Edsol/esphome-ideal-clima-nemo/board_images/1.jpg

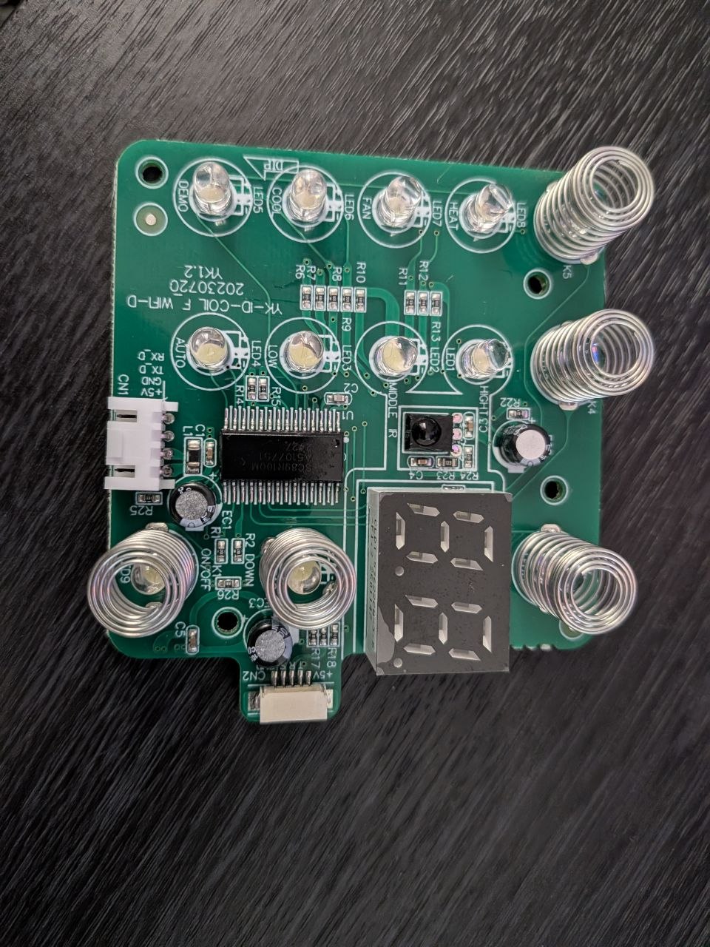
board_images/1.jpg
