Edsol/esphome-ideal-clima-nemo/board_images/2.jpg

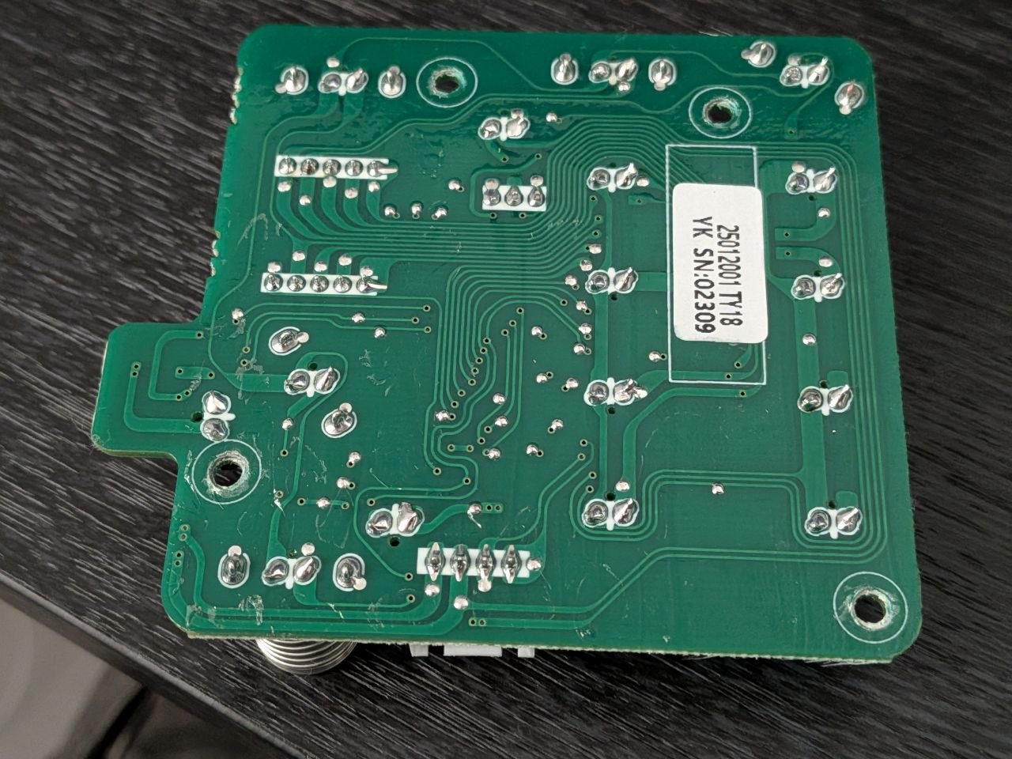
board_images/2.jpg
