Edsol/esphome-ideal-clima-nemo/board_images/3.jpg

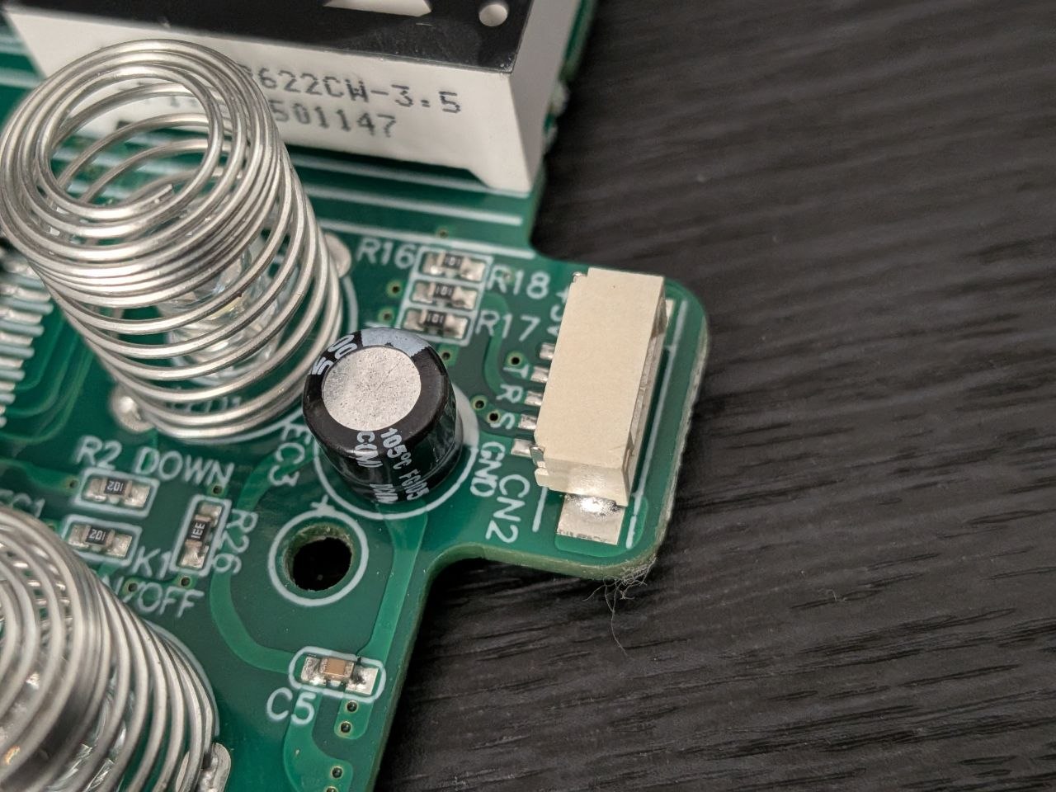
board_images/3.jpg
