Edsol/esphome-ideal-clima-nemo/board_images/4.jpg

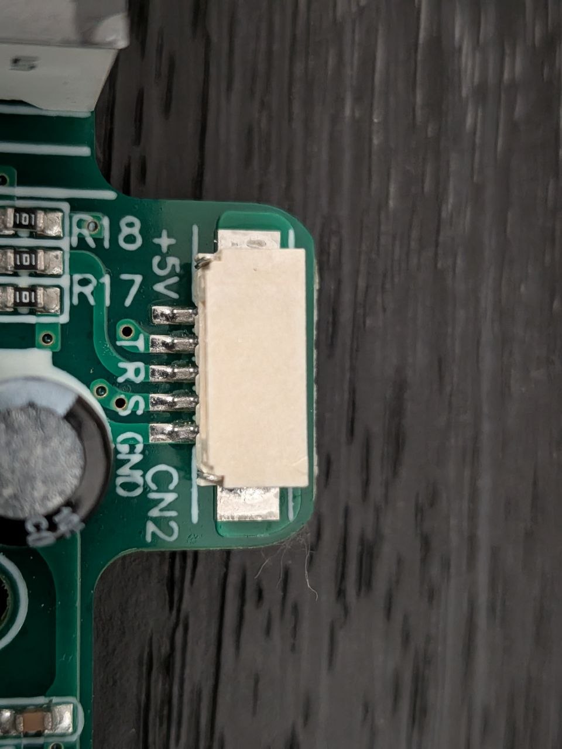
board_images/4.jpg
