Edsol/esphome-ideal-clima-nemo/board_images/5.jpg

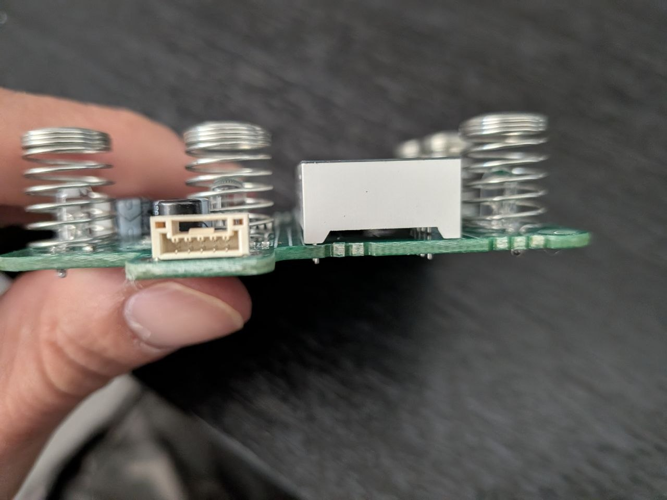
board_images/5.jpg
