Edsol/esphome-ideal-clima-nemo/board_images/6.jpg

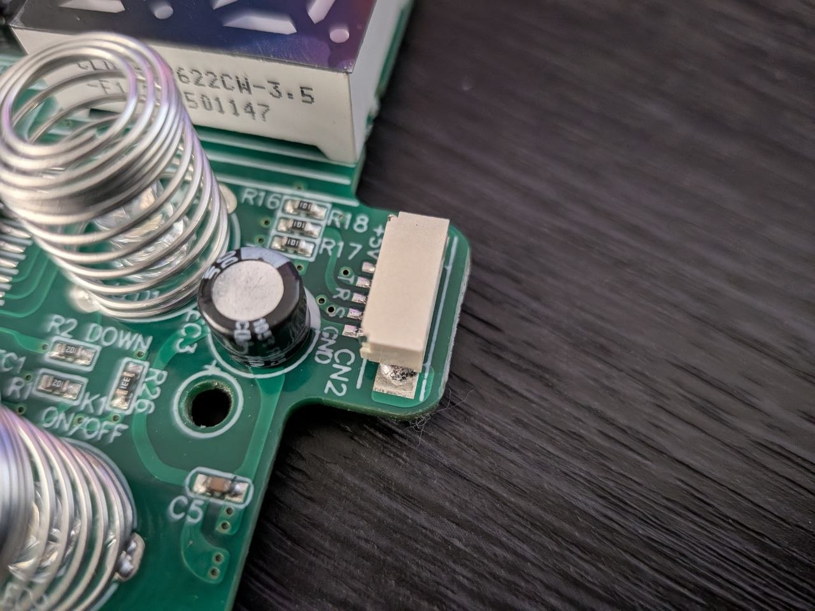
board_images/6.jpg
