Edsol/esphome-ideal-clima-nemo/(commit log)

2026-06-20 Initial public release: Ideal Clima Nemo 1000 local control (ESP32-C3)
    Reverse-engineered Tuya MCU integration over the CN2 connector, with two
    Home Assistant integrations sharing a common core library:
    - esp32/ IdealClimaTuya core library + Arduino example + wiring guide
    - esphome/ native ESPHome climate component
    - mqtt/ PlatformIO firmware with MQTT + HA discovery
    - extra/ PC tools (passive sniffer + terminal controller)
    All docs/comments in English. Direct 3.3V wiring on CN2 (no divider).
    Secrets templated and gitignored.
2026-06-21 Fix ESPHome mode mapping, add build docs and packaging for publication
    - Fix critical bug: ESPHome component had mode enum swapped (heat=0/cool=1),
    now aligned to the verified protocol (cool=0/heat=1/dehu=2/fan=3) like the
    core lib, MQTT firmware and PC tools. Verified: `esphome compile` succeeds.
    - esphome: entity name: None (avoids the doubled name in Home Assistant);
    plausible per-mode setpoint ranges; sibling-comment YAML hardened vs linter.
    - mqtt: add README with build/flash steps; move credentials out of platformio.ini
    into a git-ignored secrets.ini (secrets.ini.example provided).
    - esp32: add library.properties for Arduino IDE alongside library.json.
    - extra: add requirements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
    [ideal_clima_fancoil.h]
2026-06-21 docs: move display photo into board_images/, document CN2 connector
    - Move display.jpg -> board_images/display.jpg
    - Specify CN2 as JST 1.25mm 5-pin and link a compatible pigtail
    (README, esp32/WIRING.md, CLAUDE.md)
2026-06-21 README: split display panel icons into mode vs fan-speed columns
